IamMrCupp/clickfinity-openscad/(commit log)

2026-07-08 feat: scaffold parametric Clickfinity baseplate generator
    [1x1_test.scad, clickfinity.scad]
2026-07-09 feat(arm): tangential flexure latch + relief pocket (behind default-off flag)
2026-07-10 fix(arm): free the flexure span; correct defaults from 655N to 22N
2026-07-10 feat: add 1x1 test bin for click-tuning
    [test_bin.scad]
2026-07-11 feat(arm): replace bridge blade with full-height cantilever tongue
    [1x1_test.scad, clickfinity.scad]
2026-07-11 fix(arm): soften tongue to survive flexing (67->21 MPa root stress)
2026-07-12 feat(arm): shallow plate + localized free-end catch (fixes jam/push-out/crack)
    [2x2_test.scad]
2026-07-13 feat(plate): thicken floor 0.8->1.2mm for base rigidity
2026-07-13 docs: rewrite README for the working shallow-plate tongue latch
2026-07-13 feat(join): built-in edge dovetails for plate-to-plate joining
2026-08-01 fix(join): dovetail female was capped and mis-tapered — add printable test
    [dovetail_test.scad]
2026-08-01 fix(join): replace unbuildable edge dovetails with underside bowtie keys
    [dovetail_test.scad, join_test.scad]
2026-08-01 fix(gridfinity): keep bin foot hulls out of the body block
2026-08-06 docs: plate joining shipped — bowtie keys, print-confirmed
2026-08-08 feat(join): expose JOIN in the customizer + add connector_keys batch file
    [clickfinity.scad, connector_keys.scad]
2026-08-08 docs: public-launch prep — STL quick-start and -D CLI usage
2026-08-18 feat(mount): opt-in countersunk mounting holes at cell centres
    [clickfinity.scad]
